TjTheDj2011/esdl-warehouse-ventilation/docs/05_schematic.pdf

# SHEET 1 - CONTROLLER, SENSORS, DISPLAY

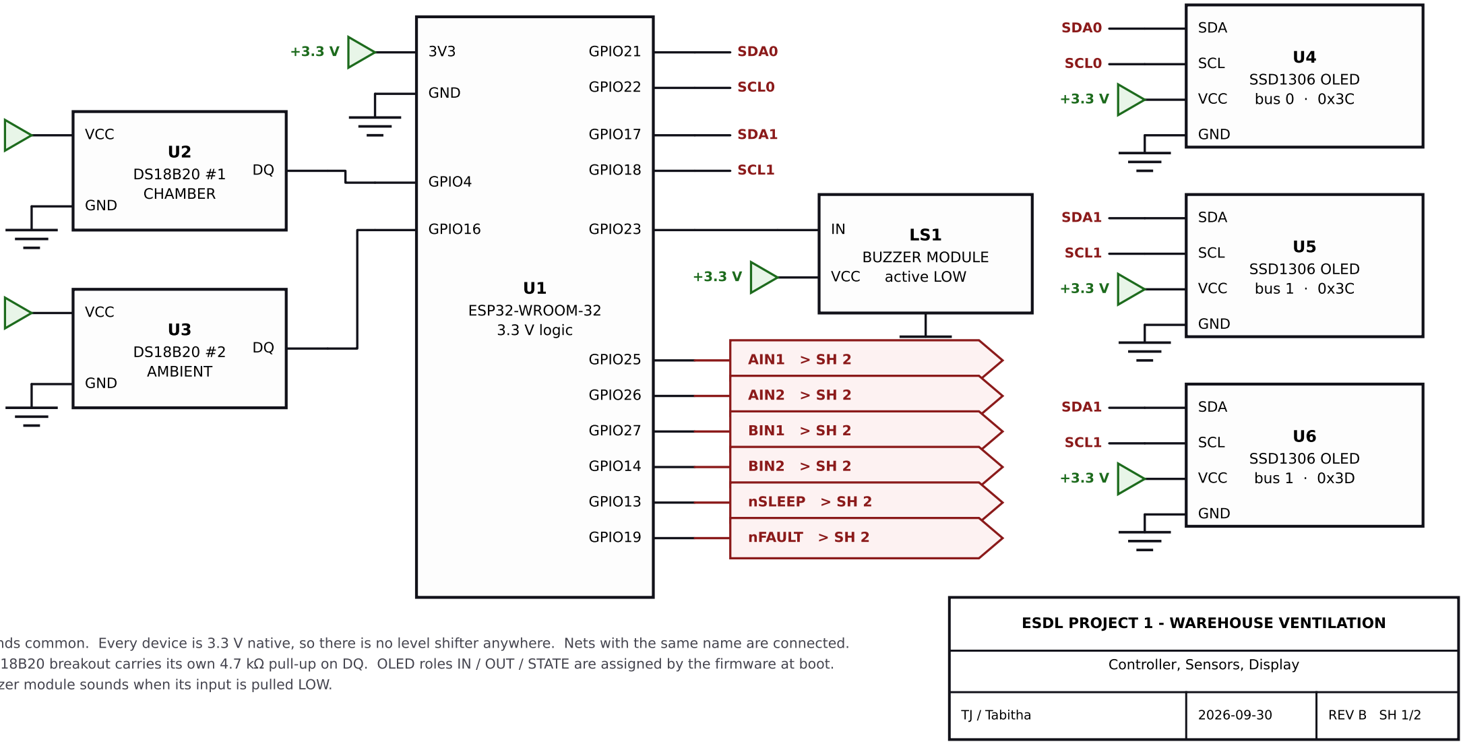
[picture p3: figure]
ESP32-WROOM-32 3.3 V logic; GND; GPIO4; GPIO16; GPIO21; GPIO22; GPIO17; GPIO18; GPIO23; GPIO25; GPIO26; GPIO27; GPIO14; GPIO13; GPIO19; DS18B20 #1 CHAMBER; VCC; DS18B20 #2 AMBIENT; SDA0; SCL0; SDA1; SCL1; BUZZER MODULE active LOW; AIN1 > SH 2; AIN2 > SH 2; BIN1 > SH 2; BIN2 > SH 2; nSLEEP > SH 2; nFAULT > SH 2; SSD1306 OLED bus 0 · 0x3C; SDA; SCL; SSD1306 OLED bus 1 · 0x3C; SSD1306 OLED bus 1 · 0x3D; ESDL PROJECT 1 - WAREHOUSE VENTILATION; Controller, Sensors, Display; TJ / Tabitha; REV B SH 1/2

All grounds common. Every device is 3.3 V native, so there is no level shifter anywhere. Nets with the same name are connected. Each DS18B20 breakout carries its own 4.7 k pull-up on DQ. OLED roles IN / OUT / STATE are assigned by the firmware at boot. The buzzer module sounds when its input is pulled LOW.

+3.3 V

+3.3 V

# SHEET 2 - FAN DRIVE AND POWER

red (+)

black

red (+)

black

## to ESP32 GND (sheet 1)

Fans are brushless and only ever switched one direction, so no suppression capacitors are fitted.
nSLEEP must be driven HIGH or the bridge stays off. nFAULT is open drain: GPIO 19 reads it through the internal pull-up. Fan power never passes through the ESP32, which runs from USB.

U7
DRV8833
DUAL H-BRIDGE

AIN1

AIN2

BIN1

BIN2

nSLEEP

nFAULT

VM

GND

AOUT1

AOUT2

BOUT1

BOUT2

### SH 1 > AIN1

### SH 1 > AIN2

### SH 1 > BIN1

### SH 1 > BIN2

### SH 1 > nSLEEP

### SH 1 > nFAULT

M

M1
INTAKE FAN
80 mm brushless, 5 V

M

M2
EXHAUST FAN
80 mm brushless, 5 V

+

PS1
5 V 2 A
wall supply
FANS ONLY

## COMMON GROUND IS MANDATORY

PS1 negative, U7 GND and the ESP32 GND must all tie together, or the H-bridge sees no valid logic level and the fans will not run.

## ESDL PROJECT 1 - WAREHOUSE VENTILATION

Fan Drive and Power

TJ / Tabitha | 2026-09-30 | REV B SH 2/2
