TjTheDj2011/esdl-warehouse-ventilation/docs/04_engineering_diagrams.pdf

# System Block Diagram

ESDL Project 1 | Automated Warehouse Ventilation Controller | ESP32-WROOM-32 | 3x SSD1306 OLED, 3.3 V native throughout

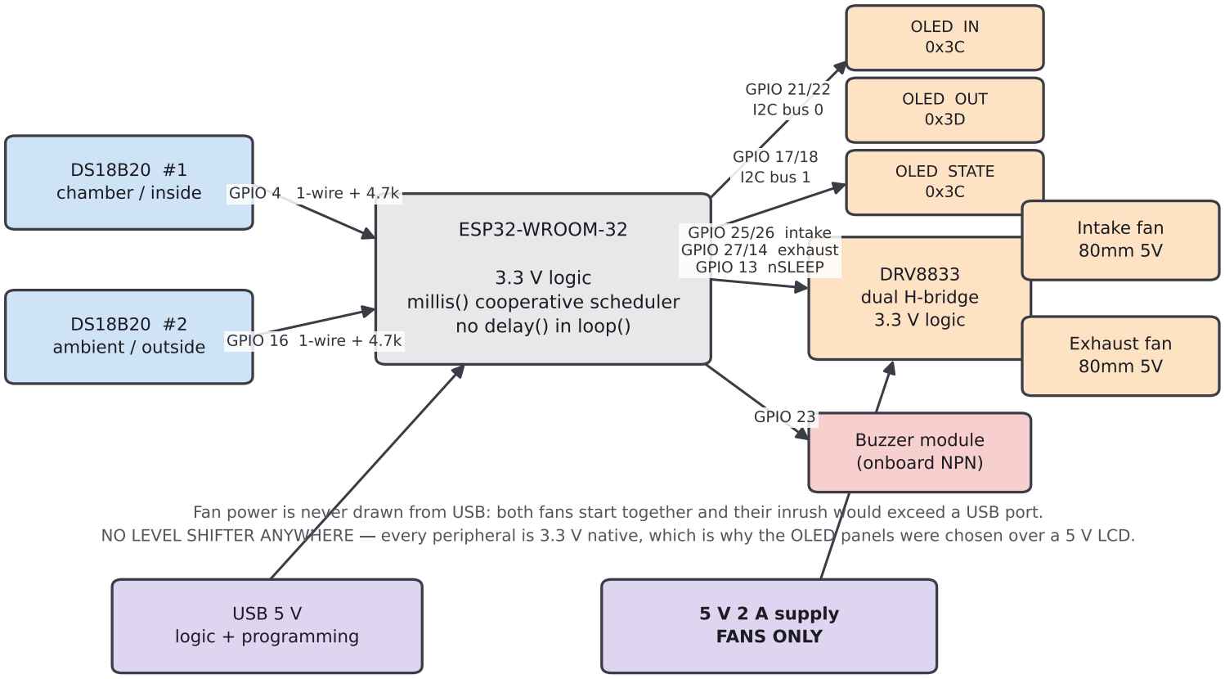
[picture p4: figure]
ESP32-WROOM-32; 3.3 V logic millis() cooperative scheduler no delay() in loop(); DS18B20 #1 chamber / inside; DS18B20 #2 ambient / outside; OLED IN 0x3C; OLED OUT 0x3D; OLED STATE 0x3C; GPIO 21/22 I2C bus 0; GPIO 17/18 I2C bus 1; DRV8833 dual H-bridge 3.3 V logic; Intake fan 80mm 5V; Exhaust fan 80mm 5V; Buzzer module (onboard NPN); USB 5 V logic + programming; 5 V 2 A supply FANS ONLY; GPIO 4 1-wire + 4.7k; GPIO 16 1-wire + 4.7k; GPIO 25/26 intake GPIO 27/14 exhaust GPIO 13 nSLEEP; GPIO 23

COMMON | GROUND REQUIRED | supply negative ties to ESP32 GND, or the H-bridge sees no valid logic level

Fan power is never drawn from USB: both fans start together and their inrush would exceed a USB port. NO LEVEL SHIFTER ANYWHERE every peripheral is 3.3 V native, which is why the OLED panels were chosen over a 5 V LCD.

Pin assignments are authoritative in hardware/01_pinout.md

# Control Logic Flowchart

One pass per control tick (2.5 s). Governing rule: move air only when the air pulled in is cooler than the air pushed out.

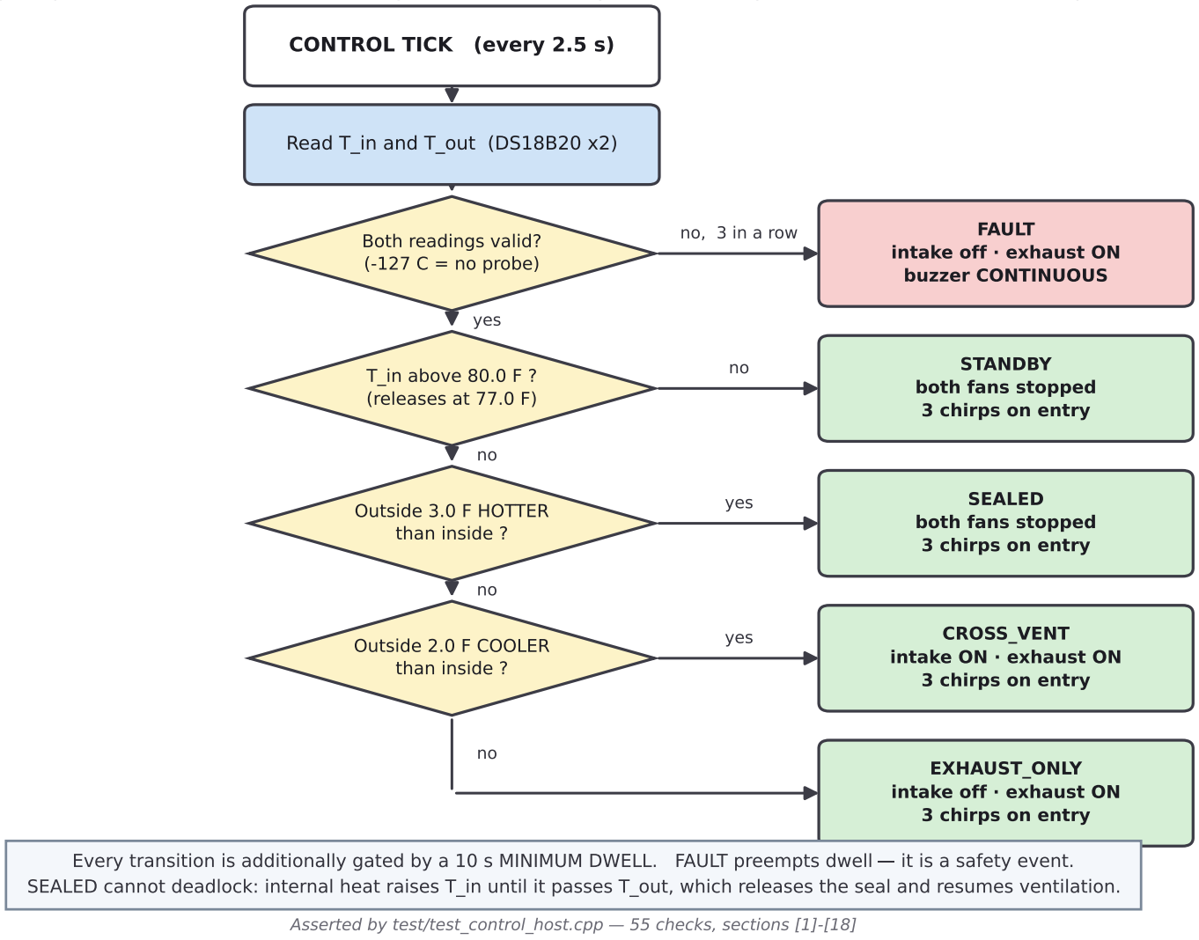
[picture p5: figure]
CONTROL TICK (every 2.5 s); Read T_in and T_out (DS18B20 x2); Both readings valid? (-127 C = no probe); T_in above 80.0 F ? (releases at 77.0 F); Outside 3.0 F HOTTER than inside ?; Outside 2.0 F COOLER than inside ?; FAULT intake off · exhaust ON buzzer CONTINUOUS; STANDBY both fans stopped 3 chirps on entry; SEALED both fans stopped 3 chirps on entry; CROSS_VENT intake ON · exhaust ON 3 chirps on entry; EXHAUST_ONLY intake off · exhaust ON 3 chirps on entry; Asserted by test/test_control_host.cpp; 55 checks, sections [1]-[18]; yes; no, 3 in a row

Every transition is additionally gated by a 10 s MINIMUM DWELL. FAULT preempts dwell it is a safety event. SEALED cannot deadlock: internal heat raises T_in until it passes T_out, which releases the seal and resumes ventilation.

# Decision Bands and Hysteresis

Why the controller does not chatter: every boundary engages and releases at different values.

## Chamber temperature T_in

STANDBY
fans idle

LATCHED
holds previous

ACTIVE
ventilation states

### 77.0 F

release

### 80.0 F

engage

3 F of hysteresis. A bare threshold would chatter the fans on sensor noise.

## Temperature difference D = T_in - T_out

SEALED
no exchange

EXHAUST_ONLY
both fans blow out

CROSS_VENT
directed jet
outside HOTTER | outside COOLER

-3.0 F seal
-1.5 F release

+2.0 F open
+1.0 F release

### Why these numbers

Each DS18B20 is accurate to +/-0.5 C, so the difference D carries about +/-1.0 C (+/-1.8 F) of uncertainty.
Both differential thresholds sit outside that band, so the controller never acts on sensor noise only on a real difference. The seal threshold of 3.0 F is reasoned, NOT yet measured. Determine it on the bench and update this figure.

Thresholds defined in firmware/src/control.cpp :: default_vent_config()

# Enclosure Airflow by State

Transparent box, diagonal wind tunnel. Intake LOW on one wall, exhaust HIGH on the opposite wall - working with buoyancy, not against it.

## CROSS_VENT

outside is at least 2 F cooler

EX

IN

intake ON · exhaust ON

Low in, high out - works with buoyancy. Directed diagonal sweep.

## EXHAUST_ONLY

inside and outside within ~3 F

EX

IN

intake OFF · exhaust ON

Exhaust alone. Makeup air is drawn IN through the idle intake fan, low down.

## SEALED

outside is at least 3 F HOTTER

EX

IN

intake OFF · exhaust OFF

No forced exchange - moving air would import heat. Idle fans leak slowly.

## STANDBY

chamber below 77 F

EX

IN

intake OFF · exhaust OFF

Nothing to do. Chamber is already below setpoint.

FAULT commands the same airflow as EXHAUST_ONLY with a continuous alarm tone bounded near ambient beats an unbounded heat soak.
