TjTheDj2011/esdl-warehouse-ventilation/docs/slides/schematic-sheet2.png

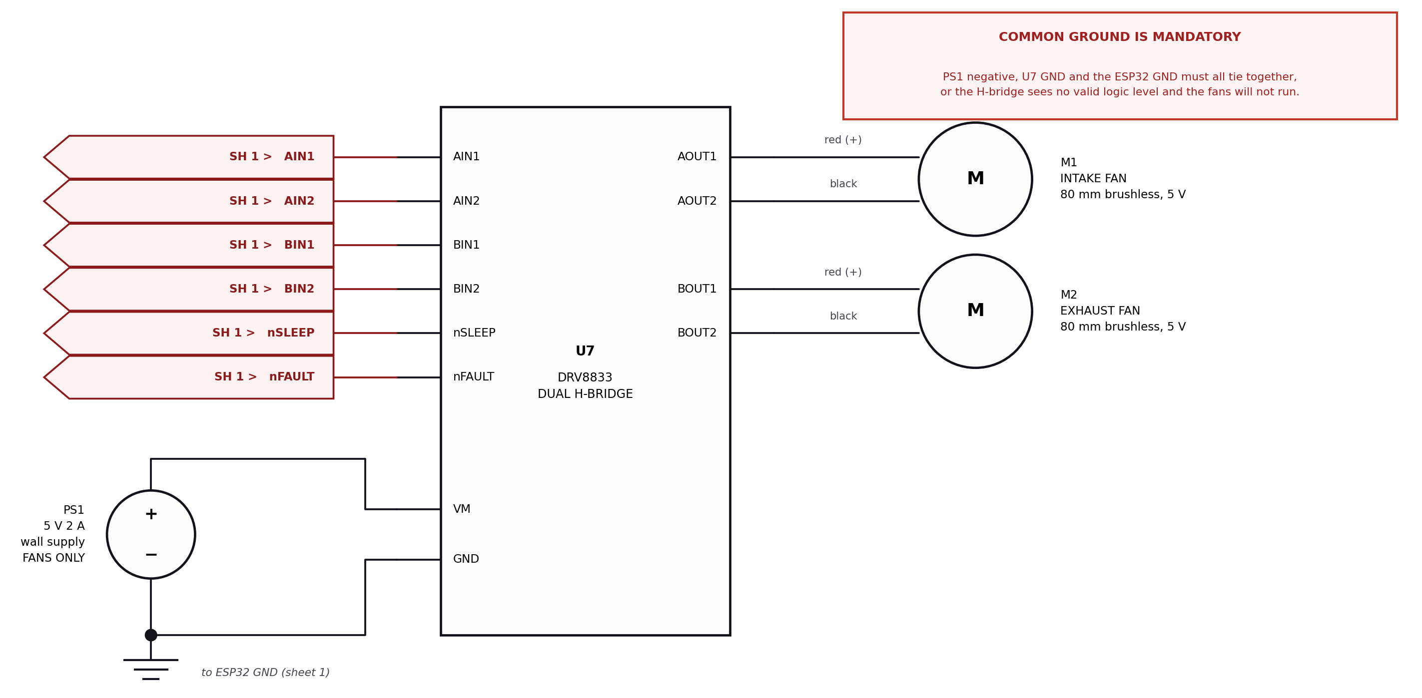
docs/slides/schematic-sheet2.png
