TjTheDj2011/esdl-warehouse-ventilation/hardware/02_bom_shopping_list.md

# BOM / Shopping List — MOVED

This list has been merged into **`03_physical_build.md`**, which now holds the
full parts list alongside what to build with them and in what order.

See: [03_physical_build.md](03_physical_build.md) — Part A is the buy list.
