TjTheDj2011/esdl-warehouse-ventilation/docs/06_wiring_diagram.pdf

SHEET 1 - SENSORS, DISPLAYS AND ALARM | USB-C

### ESP32-WROOM-32

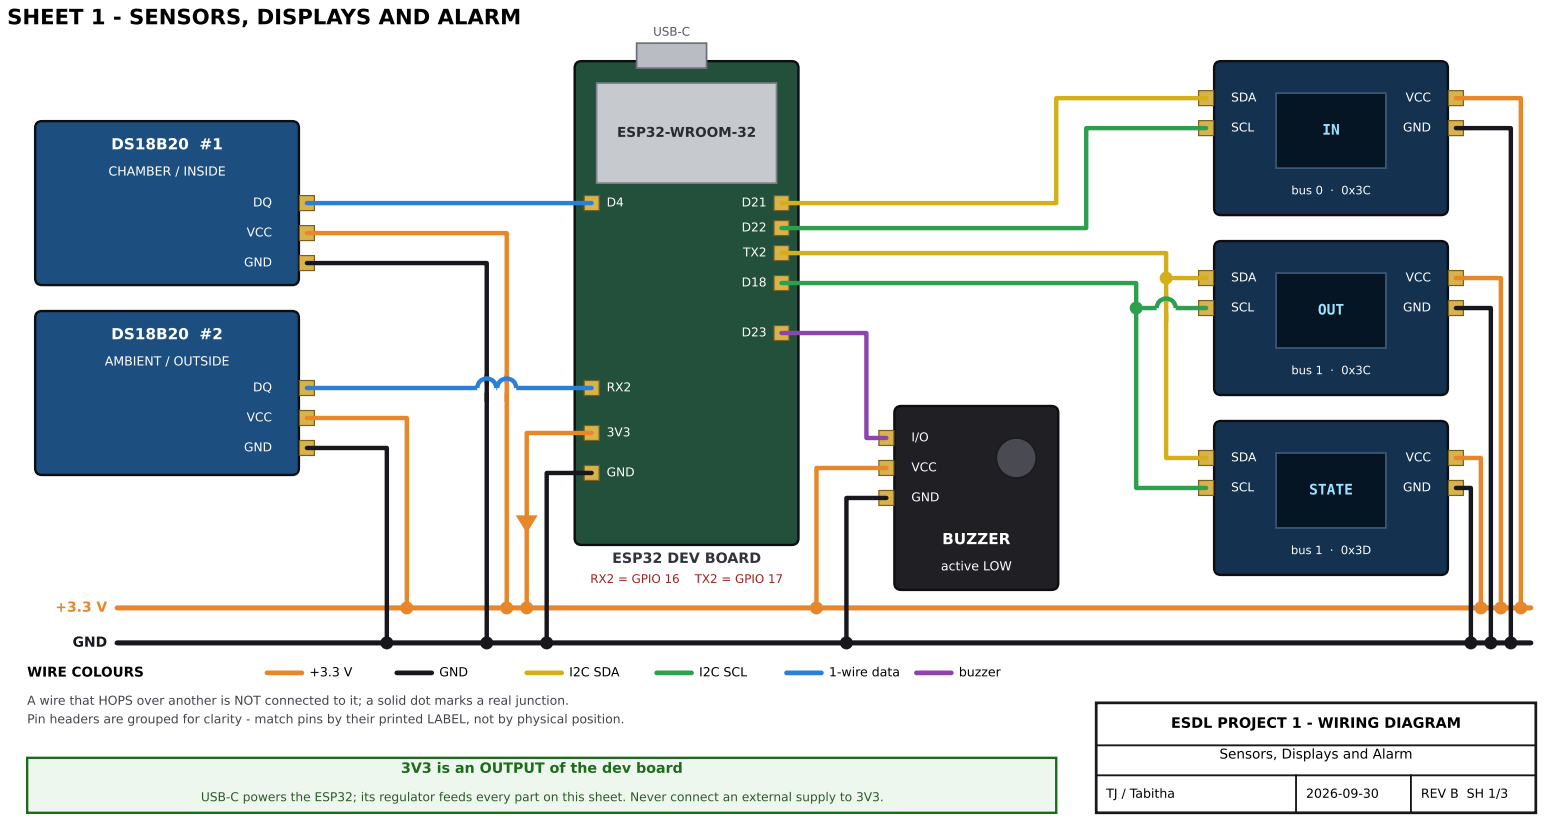
[picture p7: page 1]
ESP32 DEV BOARD; RX2 = GPIO 16; TX2 = GPIO 17; GND; WIRE COLOURS; CHAMBER / INSIDE; AMBIENT / OUTSIDE; bus 0 · 0x3C; OUT; bus 1 · 0x3C; STATE; bus 1 · 0x3D; BUZZER; active LOW; VCC; SDA; SCL; I2C SDA; I2C SCL; 1-wire data; buzzer; TJ / Tabitha; REV B SH 1/3

A wire that HOPS over another is NOT connected to it; a solid dot marks a real junction.
Pin headers are grouped for clarity - match pins by their printed LABEL, not by physical position.

ESDL PROJECT 1 - WIRING DIAGRAM

Sensors, Displays and Alarm

3V3 is an OUTPUT of the dev board

USB-C powers the ESP32; its regulator feeds every part on this sheet. Never connect an external supply to 3V3.

# SHEET 2 - FAN DRIVE AND POWER

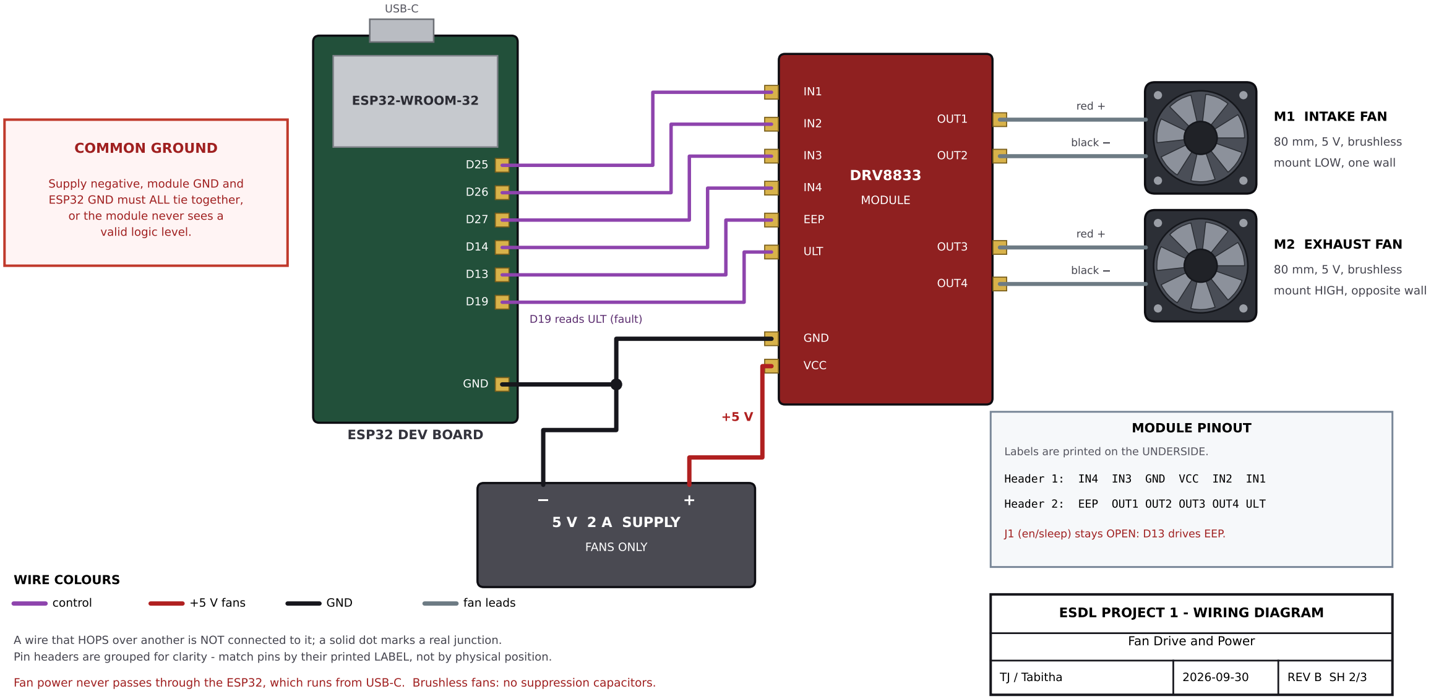
[picture p8: figure]
USB-C; ESP32 DEV BOARD; D19 reads ULT (fault); M1 INTAKE FAN; 80 mm, 5 V, brushless; mount LOW, one wall; M2 EXHAUST FAN; mount HIGH, opposite wall; red +; black; WIRE COLOURS; ESP32-WROOM-32; DRV8833; MODULE; 5 V 2 A SUPPLY; FANS ONLY; GND; EEP; ULT; VCC; OUT1; OUT2; OUT3; OUT4; COMMON GROUND; Supply negative, module GND and ESP32 GND must ALL tie together, or the module never sees a valid logic level.; MODULE PINOUT; Labels are printed on the UNDERSIDE.; Header 1: IN4 IN3 GND VCC IN2 IN1; Header 2: EEP OUT1 OUT2 OUT3 OUT4 ULT; control; +5 V fans; fan leads; ESDL PROJECT 1 - WIRING DIAGRAM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

A wire that HOPS over another is NOT connected to it; a solid dot marks a real junction.
Pin headers are grouped for clarity - match pins by their printed LABEL, not by physical position.

Fan power never passes through the ESP32, which runs from USB-C. Brushless fans: no suppression capacitors.

J1 (en/sleep) stays OPEN: D13 drives EEP.

# SHEET 3 - CONNECTION TABLE

Tick each row as you wire it. Build one component at a time and verify it with the serial console before the next.

COMPONENT | PIN (as printed) | CONNECTS TO | WIRE | NOTE
DS18B20 #1 (inside) | DQ | ESP32 D4 (GPIO 4) | blue | module has the 4.7k pull-up
VCC / GND | +3.3 V rail / GND rail | orange / black
DS18B20 #2 (outside) | DQ | ESP32 RX2 (GPIO 16) | blue | printed RX2, not 16
VCC / GND | +3.3 V rail / GND rail | orange / black | keep clear of exhaust plume
OLED IN (bus 0, 0x3C) | SDA / SCL | ESP32 D21 / D22 | yellow / green
VCC / GND | +3.3 V rail / GND rail | orange / black | 3.3 V only - no shifter
OLED OUT (bus 1, 0x3C) | SDA / SCL | ESP32 TX2 / D18 | yellow / green | printed TX2 = GPIO 17
VCC / GND | +3.3 V rail / GND rail | orange / black
OLED STATE (bus 1, 0x3D) | SDA / SCL | same bus 1 rows as OUT | yellow / green | address pad moved to 0x3D
VCC / GND | +3.3 V rail / GND rail | orange / black
Buzzer module | I/O | ESP32 D23 (GPIO 23) | purple | active LOW: sounds when pulled low
VCC / GND | +3.3 V rail / GND rail | orange / black
DRV8833 module | IN1 / IN2 | ESP32 D25 / D26 | purple | intake fan
IN3 / IN4 | ESP32 D27 / D14 | purple | exhaust fan
EEP | ESP32 D13 (GPIO 13) | purple | HIGH enables; leave J1 open
ULT | ESP32 D19 (GPIO 19) | purple | fault output, open drain
VCC | 5 V fan supply + | red | NEVER from the ESP32
GND | supply | AND ESP32 GND | black | COMMON GROUND - mandatory
OUT1 / OUT2 | intake fan red / black | grey | fan runs one direction only
OUT3 / OUT4 | exhaust fan red / black | grey | fan runs one direction only
Power | ESP32 USB-C | computer USB port | - | powers the logic
ESP32 3V3 | +3.3 V rail | orange | an OUTPUT - sources the rail
ESP32 GND | GND rail | black
Leave unwired | GPIO 33 | nothing | - | bench-test reference pin

## ESDL PROJECT 1 - WIRING DIAGRAM

Connection Table
