TjTheDj2011/esdl-warehouse-ventilation/docs/08_tinkercad_layout.pdf

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

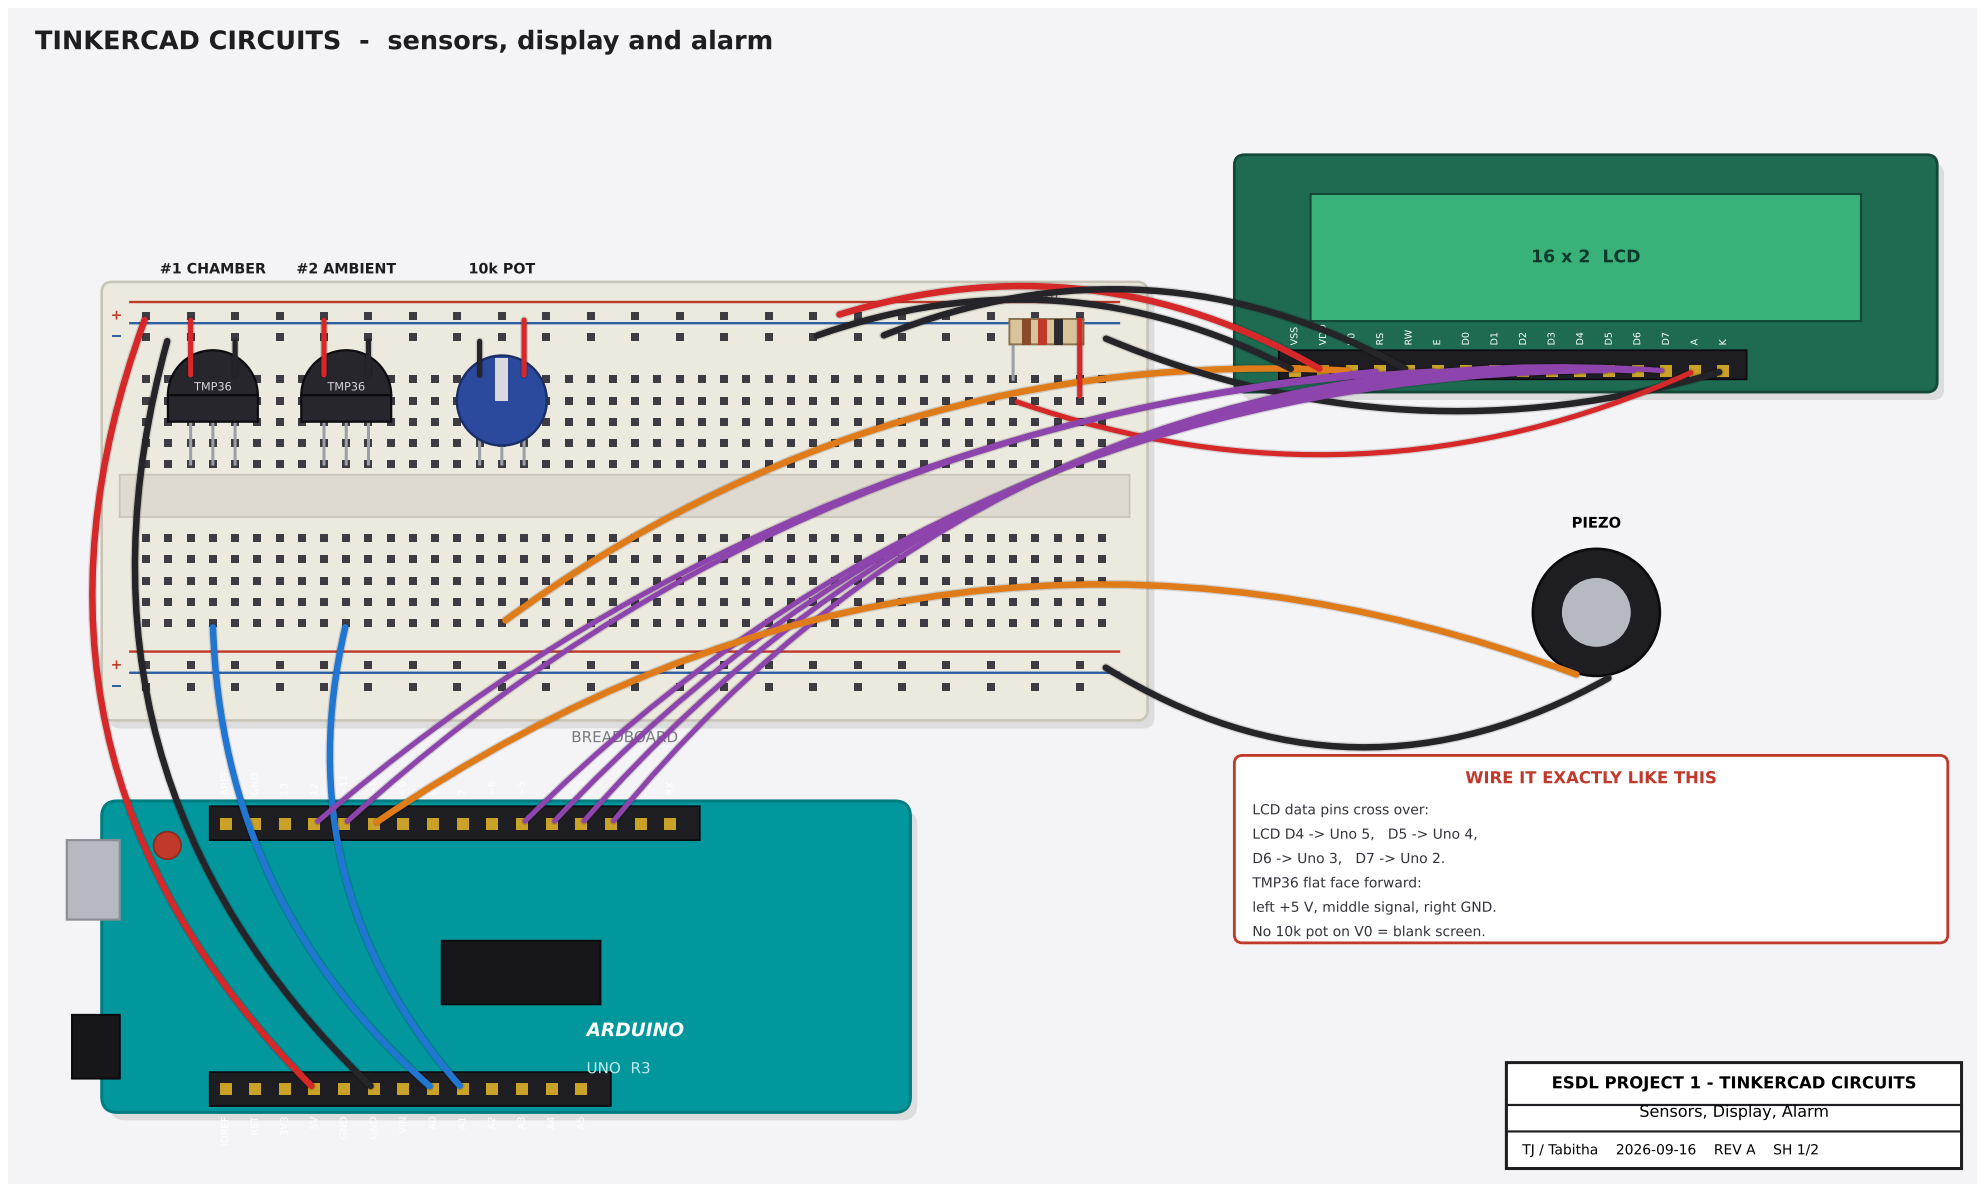
[picture p9: page 1]

# TINKERCAD CIRCUITS - motor drive

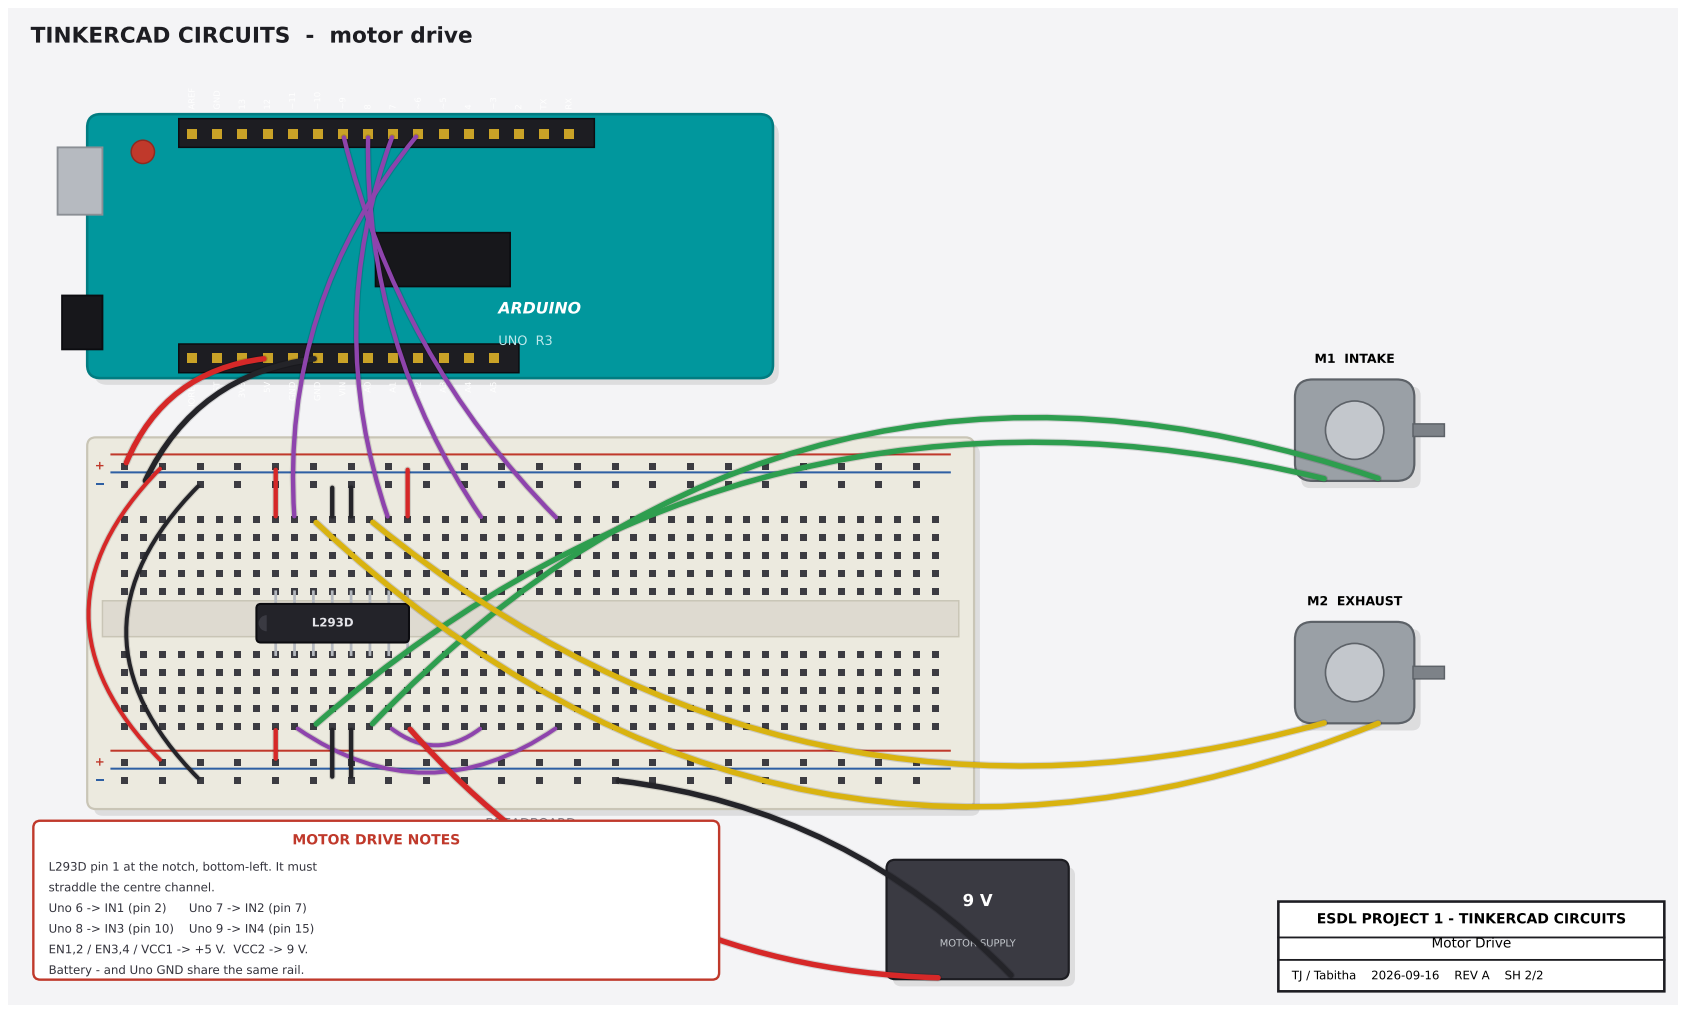
[picture p10: page 2]
BREADBOARD; M1 INTAKE; M2 EXHAUST; ARDUINO; UNO R3; AREF; GND; IOREF; RST; VIN; MOTOR SUPPLY; Uno 6 -> IN1 (pin 2); Uno 7 -> IN2 (pin 7); Uno 8 -> IN3 (pin 10); Uno 9 -> IN4 (pin 15); Motor Drive; TJ / Tabitha; REV A

MOTOR DRIVE NOTES

L293D pin 1 at the notch, bottom-left. It must
straddle the centre channel.
EN1,2 / EN3,4 / VCC1 -> +5 V. VCC2 -> 9 V.
Battery - and Uno GND share the same rail.

ESDL PROJECT 1 - TINKERCAD CIRCUITS
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
