TjTheDj2011/esdl-warehouse-ventilation/(commit log)

2026-09-10 ESDL Project 1: project brief, state machine, and standing engineering constraints
    Scaffolds the automated warehouse ventilation project separately from Howard.
    Captures the design intent (ESP32-S3 + 2x DHT22 + I2C LCD + buzzer + dual 130-size
    DC fans), the four-state thermal FSM, and the engineering constraints decided in
    the week-3 design review -- hysteresis, differential deadband, NaN fail-safe,
    backdraft damper, sensor placement, I2C level shifting, and pin selection.
2026-09-23 Week 4: firmware, hardware design, and full documentation set
    Firmware (ESP32-WROOM-32, PlatformIO):
    - Five-state control law in control.cpp, free of Arduino dependencies so it
    is provable on a host. STANDBY / CROSS_VENT / EXHAUST_ONLY / SEALED / FAULT.
    - SEALED added: ventilating while outside is hotter heats the warehouse, so
    the system stops instead. Cannot deadlock - internal heat raises T_in past
    T_out, which releases the seal.
    - DS18B20 1-wire sensors, non-blocking: start both conversions, collect ~900ms
    later, then run the control law. Never waits on a sensor.
    - Three SSD1306 OLED panels across two I2C buses (IN / OUT / STATE).
    - Serial bring-up console: per-peripheral testing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
2026-09-23 Rewrite bring-up guide for the actual hardware
    The guide still described the 16x2 LCD and DHT22s, so it would have sent us
    hunting for an LCD at 0x27 and soldering suppression capacitors that no longer
    exist in the design.
    Now covers: three OLED panels across two I2C buses including the 0x3D address
    move, DS18B20 one-wire sensors with onboard pull-ups, brushless fans on a
    separate 5V rail, and the four-rail labelling scheme for the two breadboards.
    Console commands and pin numbers verified against firmware/src.
2026-09-23 All parts purchased and on hand - checklist closed out
    Electronics, fans, supply, enclosure and tools all acquired as of 2026-09-23.
    No outstanding purchases and no open verification questions. The checklist
    becomes a pre-wiring reference; the live procedure is docs/02_bringup_guide.md.
2026-09-23 Adaptive OLED roles, and show the values the control law is acting on
    First hardware bring-up session. Two findings:
    1. Panel roles are now assigned to whatever answers, in a fixed probe order
    across both buses, instead of being pinned to fixed (bus, address) pairs.
    Two panels therefore give IN and OUT while the third still needs its
    address pad moved - no config edit between today and Friday.
    2. The trace and panels showed the real sensors while the controller was
    acting on simulated values, so the display contradicted the state it was
    driving. Found on the bench, not by any of the 51 host tests. Both now
    read shown_in_c()/shown_out_c(), which follow whatever the control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
    [main.cpp]
2026-09-23 Fix manual-override timeout underflow, and trace the driven outputs
    Two bugs found on the bench, neither reachable by the host tests.
    1. The manual-override timeout fired instantly instead of after five minutes.
    `now` is captured at the top of loop(), but poll_console() then calls
    millis() again a few microseconds later, so manual_since ended up GREATER
    than now. The unsigned subtraction underflowed to ~4.29e9, which clears any
    threshold. Effect: `intake on` set the pin, the timeout fired on the same
    pass, enter_auto() cleared it, and the fan never spun - which read exactly
    like a wiring fault. Now uses due()'s signed difference, the same
    rollover-safe idiom already use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
    [main.cpp]
2026-09-23 Bench log: session 1 results
    Both fans confirmed working direct on the 5 V rail, which also confirms the
    supply delivers. Combined with the trace showing the ESP32 holding intake=fwd,
    that isolates the remaining fault entirely to the unsoldered DRV8833 header.
    Records the measurements, the state-machine results, and the three defects
    found on hardware - with the note that none were reachable by the host tests.
2026-09-23 Buzzer is active-low: invert drive and fix the boot state
    Measured on the bench - this 3-pin module sounds on LOW and is silent on HIGH.
    Without inverting, the alarm runs exactly backwards: quiet during a fault and
    sounding the rest of the time.
    setup() was also driving the pin LOW at init, so on this module the alarm
    sounded from the instant the board powered up, before any logic ran.
    Polarity is now a named constant in config.h rather than implicit, because it
    is a property of the part and a different module would need it flipped.
    [config.h, main.cpp]
2026-09-23 Clear control latches when leaving simulation
    Found while reading status on the bench: the rig sat in CROSS_VENT with the
    chamber at 77.6 F, because an earlier 'sim 85 65' had set the hot latch and
    77.6 F is inside the 77-80 hysteresis band. The hysteresis was right; the
    latch was just set by injected data rather than by the real chamber.
    A fresh boot at 77.6 F settles to STANDBY, so the same real conditions gave
    two different states depending on history - and during a demo that reads as a
    fault. 'sim off' now calls reset_latches() so the controller re-derives from
    live data. Host check [18] asserts it.
    [control.cpp, control.h, main.cpp]
2026-09-24 Probes must not create the fault they report
    The wire probe left its drive pin LOW on exit. Sweeping nSLEEP therefore
    stranded the driver asleep, and every probe run afterwards reported a dead
    output that was only a disabled bridge. Restore the rest state, and assert
    nSLEEP in run_probe instead of trusting what the last command left behind.
    diag now says so loudly when it finds the driver disabled, rather than
    printing it as one calm status line among several.
    Also fix a hazard: SENSE_DIVIDER assumed a 1:1 divider that is not fitted on
    the bench, so diag's FORWARD step would have put VM (5 V) directly on a 3.3 V
    ADC pin had the output been working, and readings were scaled by a divider
    tha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
    [config.h, main.cpp]
2026-09-24 Node classifier that validates itself before it accuses the board
    Reading a node once tells you its level, not whether the reading is true. This
    reads the probe pin both pulled up and pulled down, and reads unwired GPIO 33
    the same way in the same call as a control. A floating node follows its pull;
    a tied one does not. If the control does not come back floating, the pull
    resistors or the read path are broken and the verdict is suppressed as a
    firmware fault rather than reported as a hardware one.
    Written because the last two faults this bench found were both mine - a
    floating sense pin, then a probe that left the driver asleep - and "I read the
    code and it looks right" is not evidence.
    Fi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
    [main.cpp]
2026-09-24 Bench rebuild sheet, and staged bring-up so faults stay attributable
    The first build went together all at once and was then debugged as a whole. One
    bad driver consequently presented as a fan fault, a power fault and a wiring
    fault at the same time, which cost most of a day.
    Adds hardware/03_rebuild_layout.md: physical layout that keeps the parts which
    fail reachable, and an eleven-stage bring-up where each stage has a command that
    proves it before the next part goes in. Stage 6 is the gate - probe an output
    with no fans attached, because that is the first test that exercises the driver
    chip rather than the wiring to it, and it is the test the dead board failed.
    Also corrects 01_pinout.md,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
2026-09-24 Coast the bridges before classifying a node
    OFF is BRAKE in this firmware, which holds the outputs at ground on purpose.
    The classifier ran straight after a probe left them braked, so it read a
    healthy output as TIED TO GROUND and called it a real short - reporting our
    own command back as a fault in the board.
    Coasting both bridges first makes an idle output read FLOATING, which is what
    it physically is. Verified on a known-good driver: node says FLOATING, probe
    says CONNECTED, same pin seconds apart.
    Third instrument bug found this way, after the floating sense pin and the probe
    that stranded the driver asleep. Each one accused the hardware of a fault the
    tool had created.
    Co-Authored-By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
    [main.cpp]
2026-09-24 Do not report a missing FAULT wire we cannot actually see
    Pulling nFAULT down detects a wire only on modules that fit their own pull-up.
    This breakout exposes the bare open-drain pin, where wired and unwired read
    identically while the chip is healthy, so the check announced NOT WIRED on a
    correctly connected pin. It now reports what it measured and states plainly
    that the wire cannot be confirmed this way.
    The pin still does its real job: a fault pulls it LOW against our pull-up.
    [main.cpp]
2026-09-24 Bench log: both fans running under firmware control
    First driver was dead. Replacing it fixed the build with no change to the
    wiring plan or the control path. All four outputs now read coast=HIGH
    brake=LOW, each isolated from the other channel, and both fans run together
    for 12 s with no brownout, no fault and no dropped serial.
    Records the three instrument bugs that sent the diagnosis down false trails,
    and the two conclusions stated past the evidence and later withdrawn, so the
    report does not repeat them as fact.
2026-09-24 Mark the session 1 header-pin conclusion as withdrawn
    It was diagnosed from a photograph and it was wrong: the pins were soldered,
    and a seated module hides them in the breadboard holes. The real fault was a
    dead driver. Struck through rather than deleted so the retraction is visible
    to anyone citing the log.
2026-09-24 Bench log: first closed-loop run on hardware
    Sensors -> FSM -> both fans, driven by hand heat, no manual commands. Engaged
    CROSS_VENT at 80.8 F and released to STANDBY at 76.9 F, holding through the
    77-80 F band without chatter, which confirms the mandated hysteresis against
    real sensor noise instead of simulation.
    Sensor identity confirmed by differential: the probe labelled INSIDE moved
    +11.8 F while OUTSIDE moved -0.1 F, so the labels match the pins and the
    control law cannot be inverted by a swapped pair.
    Outside sensor had been on the wrong pin - GPIO 16 is silkscreened RX2 on this
    board. Noted so the next person does not lose time to it.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
2026-09-24 Chirp on every state change; continuous tone only for a real fault
    A standing alarm through EXHAUST_ONLY and SEALED is punishing to stand next to
    for a whole demonstration, and it spends the loudest signal the system has on
    conditions where nothing is broken.
    Three short chirps now mark every transition - an event, saying the controller
    just decided something and the fans are about to move. The continuous tone is
    reserved for FAULT, the one state where the controller cannot trust its own
    sensors, so "broken" is never confused with "working hard". EXHAUST_ONLY and
    SEALED are announced by their entry chirp and by visible fan behaviour.
    The chirp lives in main.cpp rather than the control law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
    [control.cpp, control.h, main.cpp]
2026-09-24 Spell out CROSS VENT, and stop the stacked label running off the panel
    X-VENT is a contraction a glancing reader has to decode. The renderer already
    splits a label at its space and stacks the halves, so the label is now
    "CROSS VENT" and spells itself out.
    That exposed a real bug in the stacking. fit_size() only considers width, so
    two short words both qualified at text size 4 - 32 px a line, which stacked
    with a gap reaches y=80 on a 64 px panel and cut the bottom off the second
    word. The size is now capped by the height actually available and the pair is
    centred vertically rather than hung from a fixed top margin.
    Host check added: every label word must fit one line at text size 3, the
    sm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
    [display.cpp, display.h, esdl_vent_tinkercad.ino, main.cpp]
2026-09-24 Bench log: FAULT verified by physically pulling a sensor
    Last unverified behaviour. Missing reading rendered as --.- rather than a
    plausible 0.0, took exactly 3 consecutive bad reads to declare, failed safe to
    exhaust-on, sounded the continuous tone, named itself on the panel, and
    recovered unattended with the counter reset.
    The 0.0 case is the one that matters: a fake-cold reading would have parked the
    controller in STANDBY with the chamber heating. It does not occur.
    All five states now verified on hardware - four by injection, FAULT by breaking
    a sensor for real.
2026-09-25 Use the current syllabus: the AI policy section is not in it
    The copy analysed yesterday was a download; the current one lives in TJ's
    course folder. Diffed, they differ in exactly one place - the older copy carries
    a "Use of AI Tools and Academic Honesty Policy" section that the current one
    does not. Grading weights, schedule, report structure and every other
    requirement are identical, so the earlier analysis stands apart from that.
    There is therefore no conflict to manage: the current written syllabus imposes
    no AI restriction, and the instructor said the same verbally on 2026-09-24.
    Reports keep a short AI-use acknowledgment as ordinary practice.
    Also stops asserting that the ECE Depart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
2026-09-25 Report outline: department format and flow, scaled to a 7-week project
    Follows the College of Engineering technical report format and the ECE design
    manual's arrangement, with the capstone-only preliminaries - signature page,
    dedication, resume, hard binding - dropped as inappropriate to an ESDL project.
    Records both rubrics, which agree on where the marks are: analytical and
    experimental approach is 30 points on its own, and with subject definition and
    data analysis it is 60 of 100. Graphs and graphics is 10 and is already covered
    by the four computer-produced diagrams.
    Maps the syllabus's nine content items into the required structure rather than
    treating them as sections, and marks hone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
2026-09-25 Analytical theory and design calculations
    The syllabus requires analytical theories and design calculations and the repo
    had none. Derives every firmware threshold rather than leaving it asserted.
    Airflow and air changes per hour from the fan rating, tabulated for candidate
    tote sizes with a realistic installed derate alongside the free-air bound. Heat
    removal comes out at 11.4 W per kelvin of inside-to-outside difference, which
    also expresses SEALED as arithmetic: below zero delta the same term adds heat.
    The steady-state balance gives T_i = T_o + Q_s/(m c_p), so the ambient floor is
    a result rather than a caveat, and the time constant reduces to tau = V/Vdot
    once mass and specific heat c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
2026-09-25 Report template: editable docx plus PDF, formatted to department spec
    Both authors need something to write in, and reports are individual, so the
    template carries the shared project data and marks every block of prose as the
    author's own to write. Highlighted blocks are prose; everything unhighlighted is
    measurement, derivation or table that both authors produced and may both use.
    Page setup is already compliant - Times New Roman 12, double spaced, 1.5in top
    and left margins, 1in bottom and right - verified in the docx as 2160/1440
    twips rather than assumed. The HTML (StarWriter) input filter is required; the
    default web filter silently discards page layout.
    Pre-filled: section order per t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
2026-09-30 Schematic and flowchart redrawn to match the hardware as built
    The schematic still showed the superseded design: DHT22 sensors, a BSS138
    level shifter and a 5 V HD44780 LCD on sheet 1, and a 4xAA battery pack with
    brush-noise capacitors on sheet 2. None of that is on the bench. Both sheets are
    now what is actually wired: two DS18B20 probes, three SSD1306 panels across two
    I2C buses (one on bus 0, two on bus 1 at 0x3C and 0x3D), the buzzer on GPIO 23,
    nFAULT on GPIO 19, and a separate 5 V 2 A fan supply with no capacitors, since
    the fans are brushless. No level shifter anywhere.
    The flowchart logic was current but its buzzer text predated the chirp
    redesign - FAULT still read "4 Hz pattern"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
    [make_flowchart.py, make_schematic.py]
2026-10-01 Wiring diagram redrawn to the build, using the names printed on the parts
    Like the schematic before it, the wiring diagram still showed the superseded
    design: DHT22 sensors, a BSS138 level shifter, a 5 V 16x2 LCD and a battery,
    with a 5 V rail on sheet 1 that nothing uses any more. All three sheets now show
    what is on the bench: two DS18B20 probes, three SSD1306 panels (IN on bus 0,
    OUT and STATE sharing bus 1), the buzzer, the DRV8833 module and the separate
    5 V fan supply.
    Pins are labelled as they are PRINTED, which is what you match while wiring.
    The ESP32 uses its silkscreen names (D4, RX2, TX2, D18...), since RX2 being
    GPIO 16 is exactly what cost an hour on the bench. The driver modu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
    [make_wiring.py]
2026-10-01 Slide renders of the schematic, framed for annotation
    The schematic PDF carries a title block, sheet heading and footnotes that eat
    a quarter of the frame and shrink the circuit on a projector. This renders the
    same drawing cropped to the circuit alone, at the PDF's exact scale and with
    the figure sized to the crop, so there is no letterboxing: drawing coordinates
    map linearly to pixels. That is what lets the presentation place highlight
    boxes over exact regions of each sheet rather than by eye.
2026-10-05 Presentation: Tabitha's deck, consolidated to the 12-slide limit
    Tabitha's deck as the base, in her style - same font, layout and diagrams.
    The instructor's limit is 10-12 slides and it had 20, so related slides are
    merged: background, problem, need and goal on one; objectives with
    constraints; the alternatives folded into the selection matrix; the
    completed system with its test results; conclusion with questions and
    feedback. References stay as a hidden backup slide.
    Also: the outline no longer auto-shrinks below 18 pt; titles sit in one
    position on every content slide; the schematic uses the cropped render so the
    circuit is larger; a photo of the prototype is on the results slide; table t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
2026-10-05 Presentation: prototype photo to the outline, space held for the finished product
    The bring-up photo now sits beside the outline as the early prototype. The
    results slide keeps a marked box of the same size for the finished-product
    photo, captioned to match.
